TF2113/mobility-aid/docs/diagrams/LED_Diagram.png

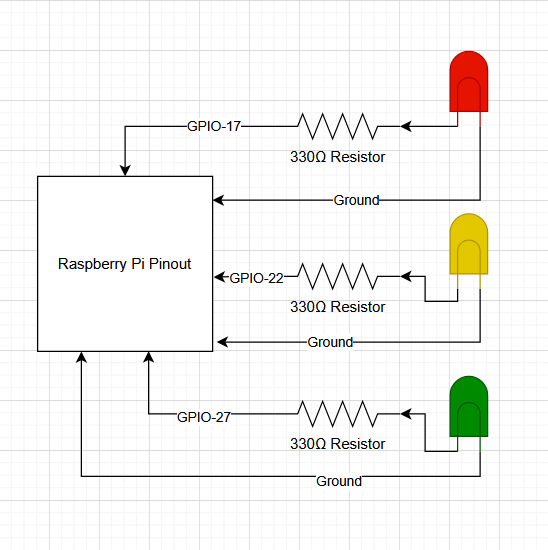
docs/diagrams/LED_Diagram.png
