TF2113/mobility-aid/docs/diagrams/Ultra_Diagram.png

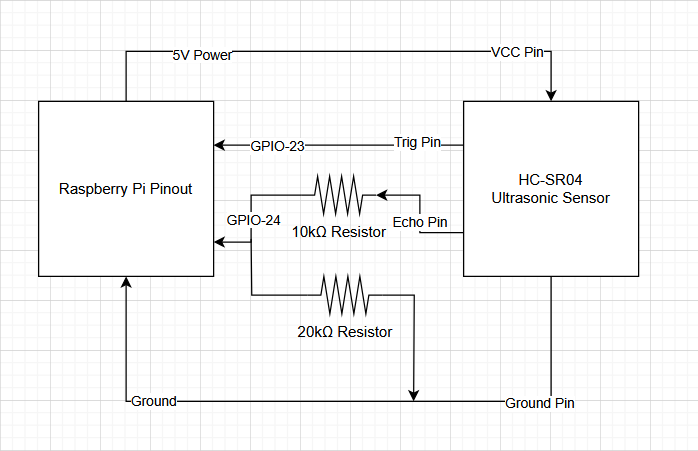
docs/diagrams/Ultra_Diagram.png
