TF2113/mobility-aid/docs/diagrams/Vib_Motor_Diagram.png

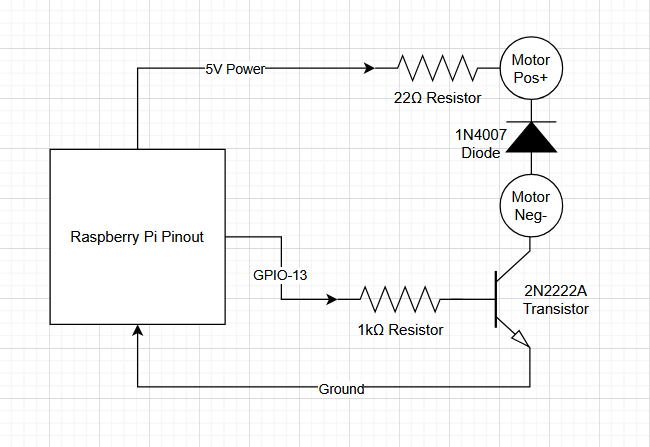
docs/diagrams/Vib_Motor_Diagram.png
