TF2113/mobility-aid/docs/pcb/mobility_aid.kicad_pcb

## KiCad design docs/pcb/mobility_aid.kicad_pcb (2025-09-03)

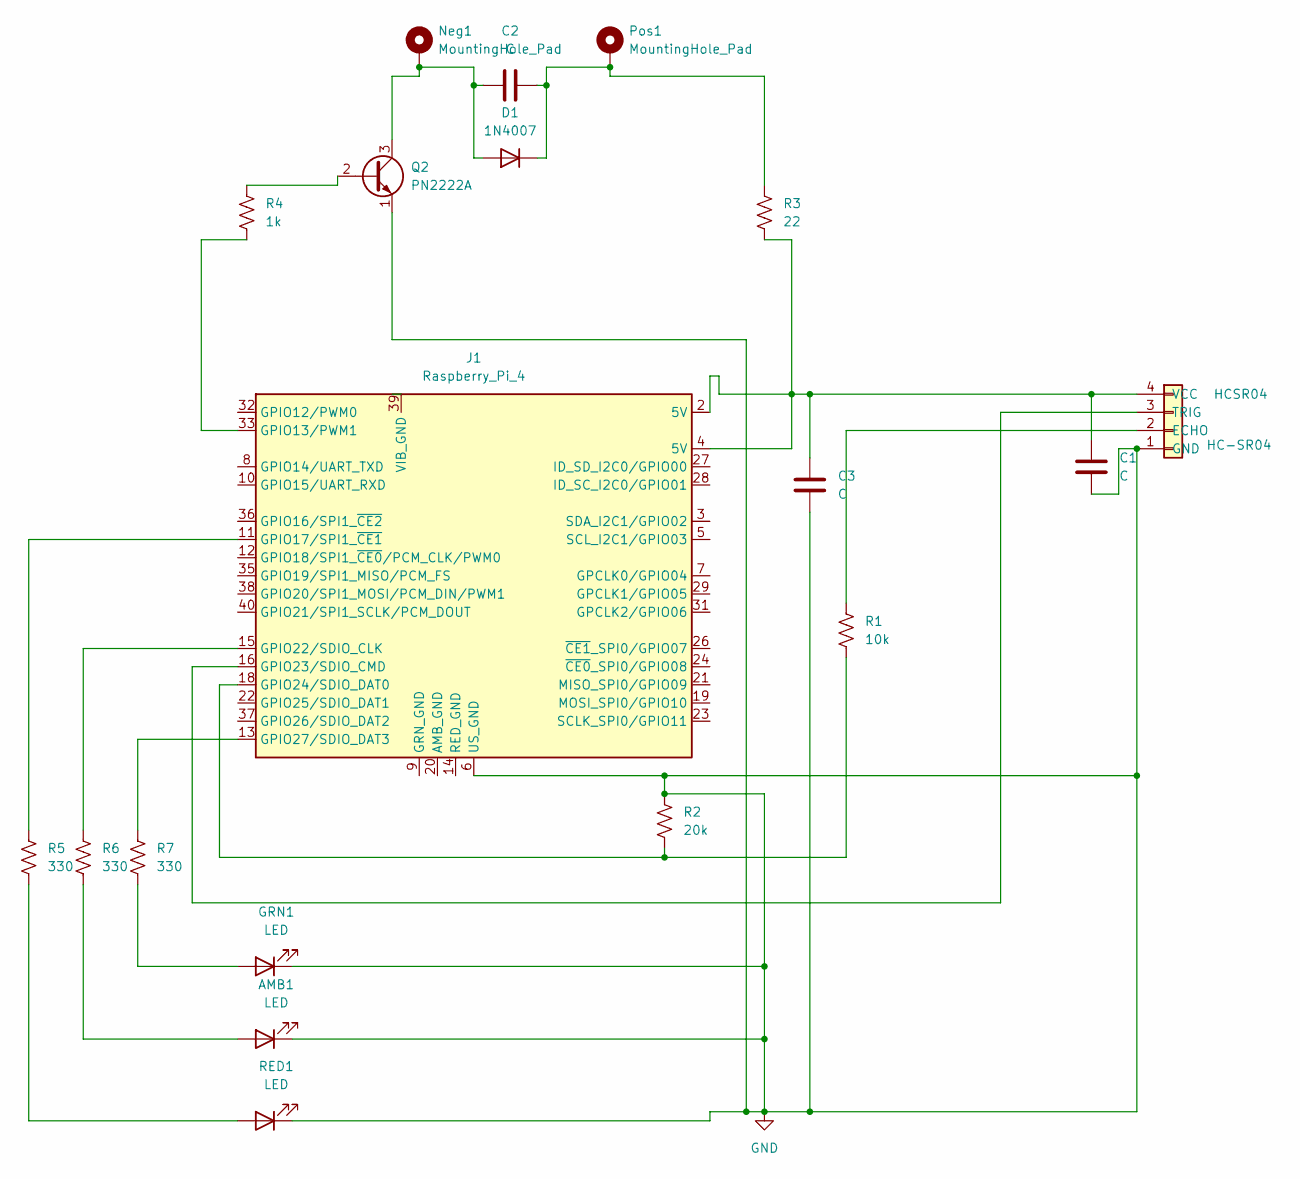
[picture p4: schematic mobility_aid.kicad_sch, Mobility Aid PCB]

Parts:
AMB1: LED; LED_D5.0mm
C1, C2: C; C_Disc_D5.0mm_W2.5mm_P2.50mm
C3: C; CP_Radial_D6.3mm_P2.50mm
D1: 1N4007; D_DO-41_SOD81_P10.16mm_Horizontal
GRN1: LED; LED_D5.0mm
HCSR04: HC-SR04; PinSocket_1x04_P2.54mm_Horizontal
J1: Raspberry_Pi_4; PinSocket_2x20_P2.54mm_Vertical
Neg1: MountingHole_Pad; MountingHole_2.5mm_Pad
Pos1: MountingHole_Pad; MountingHole_2.5mm_Pad
Q2: PN2222A; TO-92_Inline
R1: 10k; R_Axial_DIN0207_L6.3mm_D2.5mm_P7.62mm_Horizontal
R2: 20k; R_Axial_DIN0207_L6.3mm_D2.5mm_P7.62mm_Horizontal
R3: 22; R_Axial_DIN0207_L6.3mm_D2.5mm_P7.62mm_Horizontal
R4: 1k; R_Axial_DIN0207_L6.3mm_D2.5mm_P7.62mm_Horizontal
R5, R6, R7: 330; R_Axial_DIN0207_L6.3mm_D2.5mm_P7.62mm_Horizontal
RED1: LED; LED_D5.0mm

Connections:
GND: AMB1.1 (K), C1.2, C3.2, GRN1.1 (K), HCSR04.1 (GND), J1.6 (US_GND), J1.9 (GND), J1.14 (GND), J1.20 (GND), J1.25 (GND), J1.30 (GND), J1.34 (GND), J1.39 (GND), Q2.1 (E), R2.1, RED1.1 (K)
unnamed: AMB1.2 (A), R6.2
unnamed: C2.1, D1.2 (A), Neg1.1, Q2.3 (C)
unnamed: C2.2, D1.1 (K), Pos1.1, R3.1
unnamed: GRN1.2 (A), R7.2
unnamed: HCSR04.2 (ECHO), R1.1
unnamed: HCSR04.3 (TRIG), J1.16 (GPIO23/SDIO_CMD)
unnamed: C1.1, C3.1, HCSR04.4 (VCC), J1.2 (5V), J1.4 (5V), R3.2
unnamed: J1.33 (GPIO13/PWM1), R4.2
unnamed: J1.11 (GPIO17/SPI1_~CE1), R5.1
unnamed: J1.15 (GPIO22/SDIO_CLK), R6.1
unnamed: J1.18 (GPIO24/SDIO_DAT0), R1.2, R2.2
unnamed: J1.13 (GPIO27/SDIO_DAT3), R7.1
unnamed: Q2.2 (B), R4.1
unnamed: R5.2, RED1.2 (A)

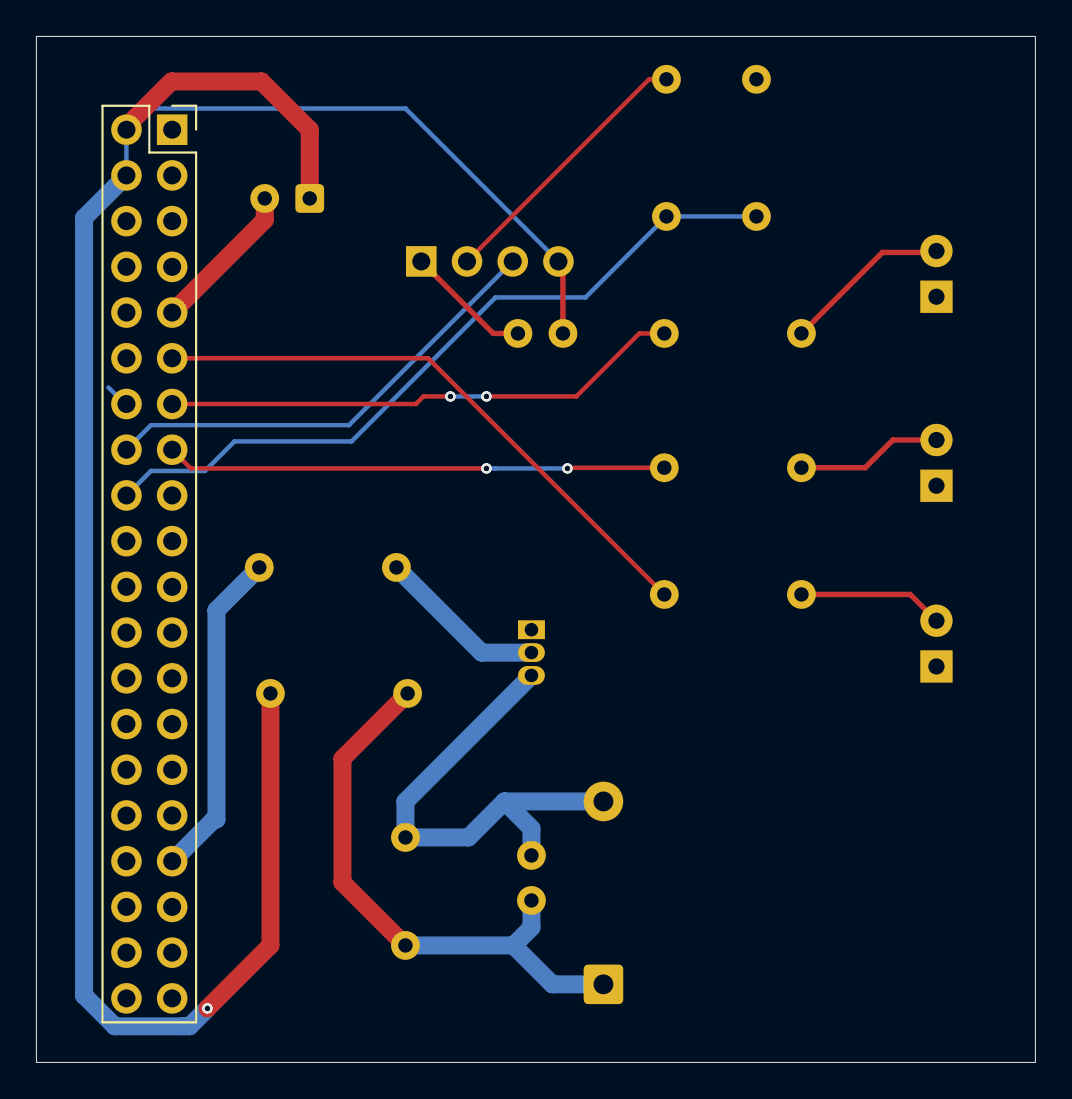
[picture p5: board mobility_aid.kicad_pcb from above]

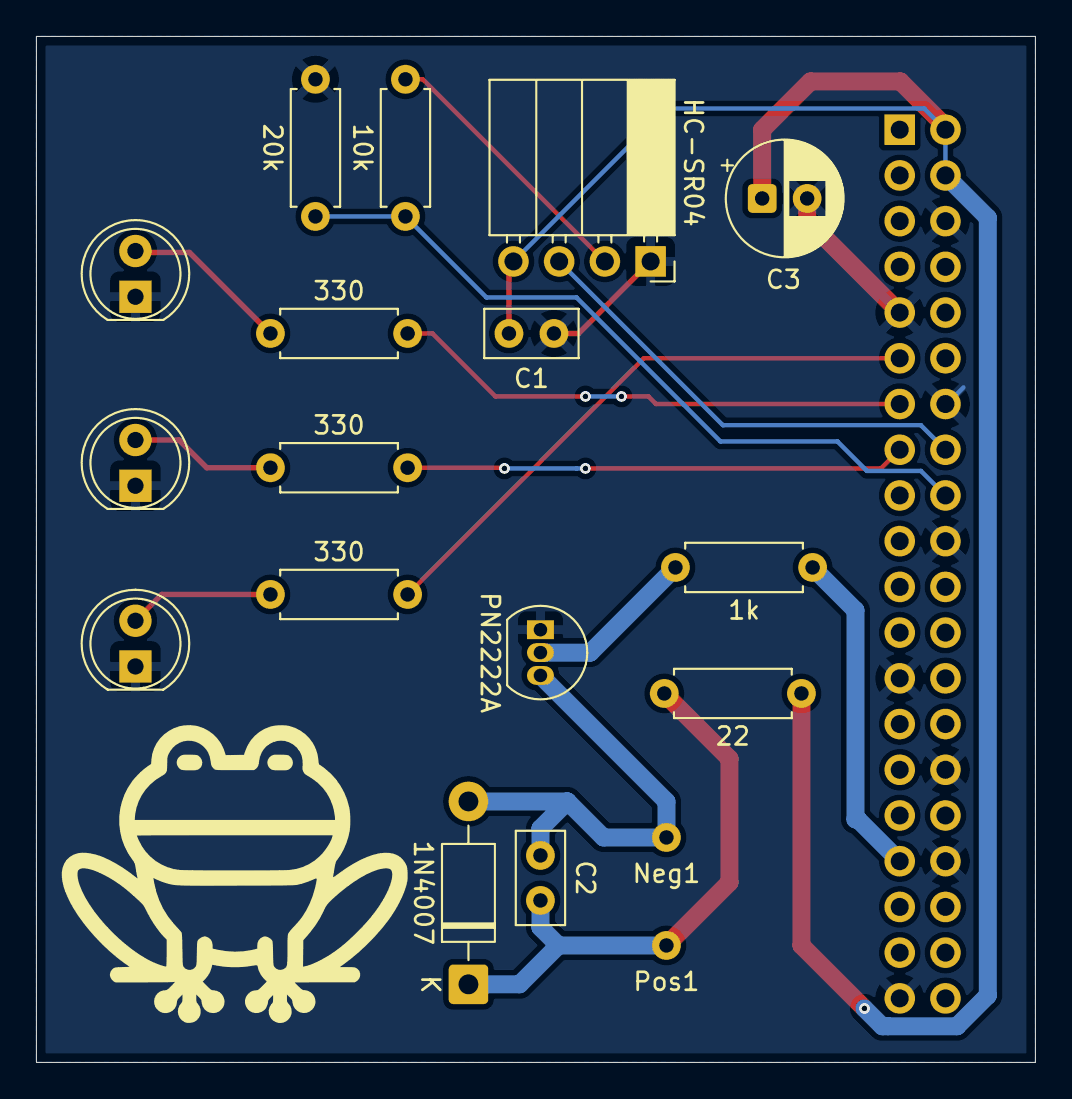
[picture p6: board mobility_aid.kicad_pcb from below]

Board: 2 copper layers, 55.5 x 57.0 mm, 19 parts (18 on the bottom side), 15 nets.
