TF2113/mobility-aid/(commit log)

2025-06-09 Initialize GPIO registers for TRIG, ECHO, and LED in proximity sensor setup
2025-06-10 Rename header and struct to avoid <time.h> conflicts, implement distance sensing with LED response
    [tick.c]
2025-06-10 Add green power indicator LED that is on while program is running
2025-06-10 Add loop to blink LED when proximity detected and print distance measured
2025-06-10 Add distance-based blinking frequency for LED
2025-06-11 Create C++ program to capture image from R Pi Camera
2025-06-11 Update Makefile to include both current programs
2025-06-13 Add yellow LED for intermediate distance added, refactor GPSEL2 logic to modify all related GPIO at once, code formatted
2025-06-16 Refactor prox_sensor to use new GPIO functions module, fix syntax bug in gpioLevel0 function
    [gpio_functions.c, gpio_functions.h]
2025-07-10 Add trained model converted to NCNN format
    [model.ncnn.param]
2025-07-10 Change ml directory structure
    [model.ncnn.param]
2025-07-11 Refactor program to use Python for inference
    [model.ncnn.param]
2025-07-11 Change image capture from libcamera to rpicam, remove camera logs from console output
2025-07-11 Add simple vibrate when certain label is detected
    [vibrate.c]
2025-07-14 Implement first version configuration dashboard for proximity settings and camera control
2025-07-16 Implement writing to config file from web app route
    [config.txt]
2025-07-16 Remove configs from git tracking
    [config.txt]
2025-07-16 Refactor proximity sensor logic to use configurable distance thresholds and load configuration at startup
2025-07-16 Refactor main loop to super loop with interrupting logic
2025-07-17 Update log to print measurement before feedback
2025-07-17 Add camera toggle functionality to web app and config update checker
2025-07-17 Add image deletion process when camera feed is turned off or program stops
2025-07-29 Refactor vibrate.c to allow for defining vibration patterns
    [vibrate.c]
2025-07-29 Add timeout to sensor readings to prevent hangs
2025-07-29 Add file lock to vibrate.c to prevent multiple concurrent calls
    [vibrate.c]
2025-07-30 Assign seperate CPU cores to C programs and Python scripts to prevent interference
    [start.py]
2025-07-30 Create header file for vibrate.c and refactor main to allow for external testing of CLI function
    [vibrate.c, vibrate.h]
2025-07-30 Add Unity testing framework to .gitignore
2025-07-30 Create mock vibrate.c cli interface functions for testing
    [vibrate_mock.c]
2025-07-30 Add header file for vibrate_mock testing
    [vibrate_mock.h]
2025-07-30 Add counter to mock functions to mimic real calls following GPIO calls in vibrate.c
    [vibrate_mock.c]
2025-07-31 Implement mock functions for functions used in vibrate.c
    [hw_mock.c]
2025-07-31 Add safe removal of output file should test case stop early
2025-07-31 Fix compile errors from incorrect returns and unused args
    [hw_mock.c]
2025-07-31 Create new version of vibrate.c without main for testing logic
    [vibrate_unit.c]
2025-07-31 Move vibrate_unit.c to mocks folder
    [vibrate_unit.c]
2025-08-01 Add correct validation of cli_vibrate types before executing
    [vibrate.c, vibrate_mock.c]
2025-08-01 Add tests for validating correct data type in CLI args
    [test_cli_runner.c, test_cli_vibrate.c]
2025-08-01 Update vibrate_unit to reflect updated vibrate.c
    [vibrate_unit.c]
2025-08-01 Update comments to clarify error
    [vibrate.c, vibrate_unit.c]
2025-08-01 Fix incorrect test logic to test vibrate_unit.c logic instead of open() directly
    [test_logic_runner.c, test_logic_vibrate.c]
2025-08-05 FIx mismatched test names
    [test_logic_runner.c]
2025-08-06 Refactor of vibrate.c to remove repeated code & improve readability
    [vibrate.c]
2025-08-06 Fix formatting due to updated Makefile
    [sys_controller.c, ultra_sensor.c]
2025-08-07 Further CPU priority optimizations to help prevent race conditions
    [start.py]
2025-08-11 Add test case for empty DB and correct assert params for unchecked camera
2025-08-11 Add additional edge case and error testing cases
2025-08-13 Upload wiring diagrams used for hardware
2025-08-13 Update system_init arg mismatch error
    [sys_logic.c]
2025-09-03 Upload PCB files to repo
